nathanpc/mini12/images/Amplifier.png

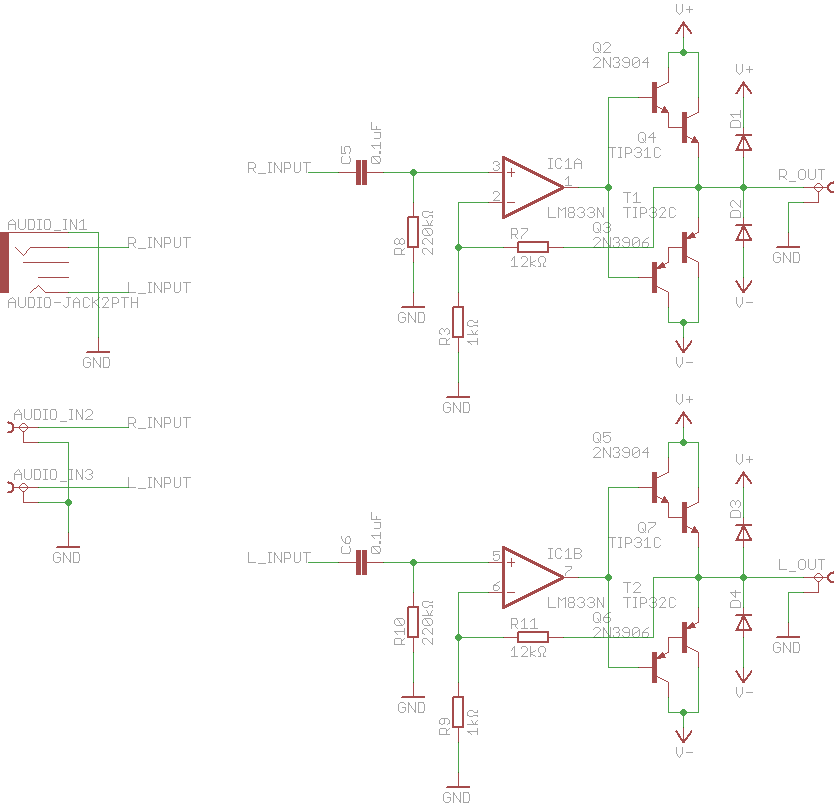
images/Amplifier.png
