nathanpc/mini12/images/Clipping Detector.png

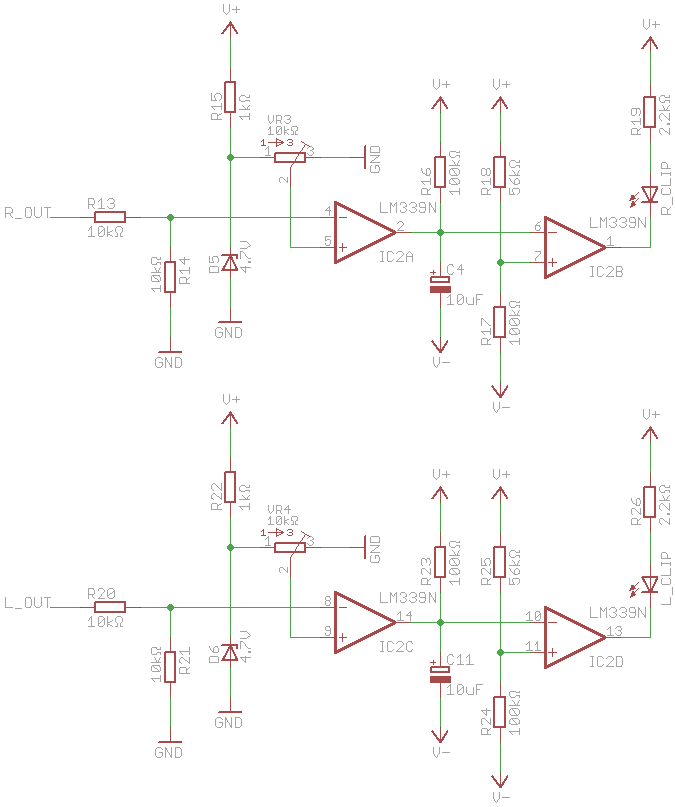
images/Clipping Detector.png
