nathanpc/mini12/images/Power Supply.png

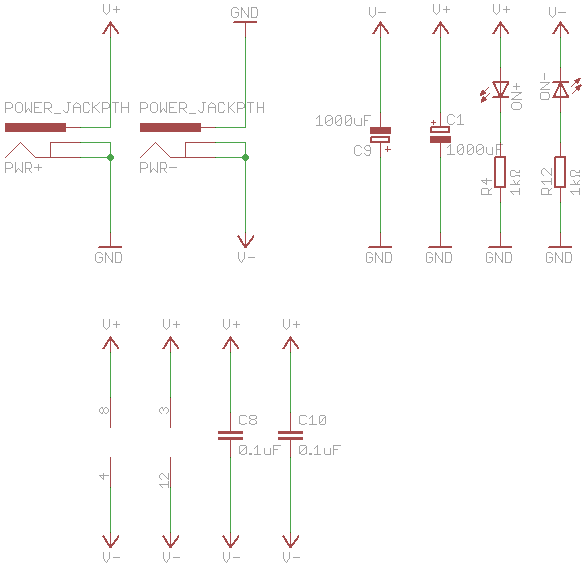
images/Power Supply.png
