nathanpc/mini12/Simulation.asc

C3: polcap; 1000µ
C4: polcap; 1000µ
C7: cap; 10µ
C9: cap; 0.22µ
D1: diode; 1N4148
D2: diode; 1N4148
Q2: npn; ""
Q3: pnp; ""
Q4: npn; 2N3904
Q5: pnp; 2N3906
R5: res; 100k
R6: res; 12k
R7: res; 8
R8: res; 1k
R17: res; 10k
R18: res; 10k
R20: res; 100k
R21: res; 1k
R22: res; 100k
R23: res; 56k
U1: opamp2; LM833
U3: LM339
U4: LM339
V1: voltage; 9V
V2: voltage; -9V
V3: voltage; SINE(0V 500mV 1kHz)
V4: voltage; 3.5V
Named nets: 0, V+, V-, Input, Output, opinput, Overload
.tran 0 10ms 0 1u
.options plotwinsize=0
.lib LM833.sub
.MODEL tip31 npn
+IS=1e-09 BF=3656.16 NF=1.23899 VAF=10
+IKF=0.0333653 ISE=1e-08 NE=2.29374 BR=0.1
+NR=1.5 VAR=100 IKR=0.333653 ISC=1e-08
+NC=1.75728 RB=6.15083 IRB=100 RBM=0.00113049
+RE=0.0001 RC=0.0491489 XTB=50 XTI=1
+EG=1.05 CJE=3.26475e-10 VJE=0.446174 MJE=0.464221
+TF=2.06218e-09 XTF=15.0842 VTF=25.7317 ITF=0.001
+CJC=3.07593e-10 VJC=0.775484 MJC=0.476498 XCJC=0.750493
+FC=0.796407 CJS=0 VJS=0.75 MJS=0.5
+TR=9.57121e-06 PTF=0 KF=0 AF=1
.MODEL tip32 pnp
+IS=1e-09 BF=134.366 NF=1.29961 VAF=10
+IKF=0.742988 ISE=1e-16 NE=1.40014 BR=0.1
+NR=1.46599 VAR=100 IKR=3.21978 ISC=1e-16
+NC=2.71657 RB=7.44433 IRB=2.41268 RBM=0.218936
+RE=0.0152284 RC=0.0761421 XTB=0.1 XTI=1
+EG=1.05 CJE=3.26474e-10 VJE=0.446178 MJE=0.464223
+TF=1e-08 XTF=3.50642 VTF=8.2848 ITF=0.0305862
+CJC=3.07595e-10 VJC=0.77548 MJC=0.476497 XCJC=0.799334
+FC=0.8 CJS=0 VJS=0.75 MJS=0.5
+TR=9.57121e-06 PTF=0 KF=0 AF=1
.four 1kHz 10 v(output)
Power Amplifier
(12x Gain)
