nathanpc/mini12/Mini12.sch

## EAGLE design Mini12.sch (2014-07-29)

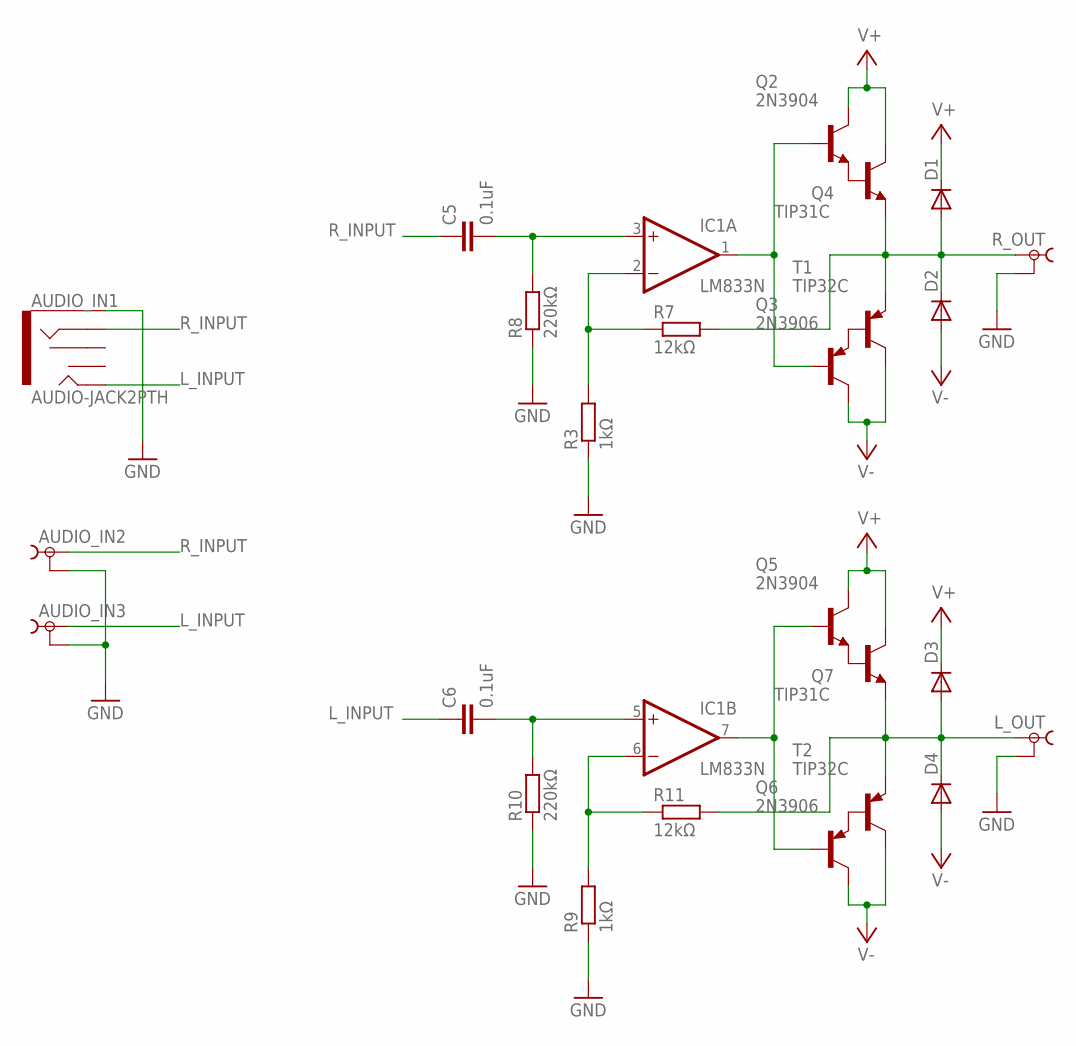
[picture p4: schematic Mini12.sch, sheet 1]

Parts:
AUDIO_IN1: AUDIO-JACK2PTH; AUDIO-JACK
AUDIO_IN2, AUDIO_IN3: TOBU3
C5, C6: 0.1uF; C025-025X050
D1, D2, D3, D4: 1N4148DO35-7; DO35-7
IC1: LM833N; DIL08
L_OUT: TOBU3
Q2, Q5: 2N3904; TO92
Q3, Q6: 2N3906; TO92
Q4, Q7: TIP31C; TO220
R3, R9: 1kΩ; 0207/10
R7, R11: 12kΩ; 0207/10
R8, R10: 220kΩ; 0207/10
R_OUT: TOBU3
T1, T2: TIP32C; TO220

Connections:
GND: AUDIO_IN1.SLEEVE, AUDIO_IN2.2, AUDIO_IN3.2, L_OUT.2, R3.1, R8.1, R9.1, R10.1, R_OUT.2
L_INPUT: AUDIO_IN1.TIP, AUDIO_IN3.1, C6.1
unnamed: IC1.2 (-IN), R3.2, R7.1
unnamed: C5.2, IC1.3 (+IN), R8.2
unnamed: IC1.6 (-IN), R9.2, R11.1
unnamed: C6.2, IC1.5 (+IN), R10.2
unnamed: Q2.3 (E), Q4.1 (B)
unnamed: Q3.3 (E), T1.1 (B)
unnamed: D1.A, D2.C, Q4.3 (E), R7.2, R_OUT.1, T1.3 (E)
unnamed: IC1.1 (OUT), Q2.2 (B), Q3.2 (B)
unnamed: Q5.3 (E), Q7.1 (B)
unnamed: Q6.3 (E), T2.1 (B)
unnamed: D3.A, D4.C, L_OUT.1, Q7.3 (E), R11.2, T2.3 (E)
unnamed: IC1.7 (OUT), Q5.2 (B), Q6.2 (B)
R_INPUT: AUDIO_IN1.RING, AUDIO_IN2.1, C5.1
V+: D1.C, D3.C, Q2.1 (C), Q4.2 (C), Q5.1 (C), Q7.2 (C)
V-: D2.A, D4.A, Q3.1 (C), Q6.1 (C), T1.2 (C), T2.2 (C)

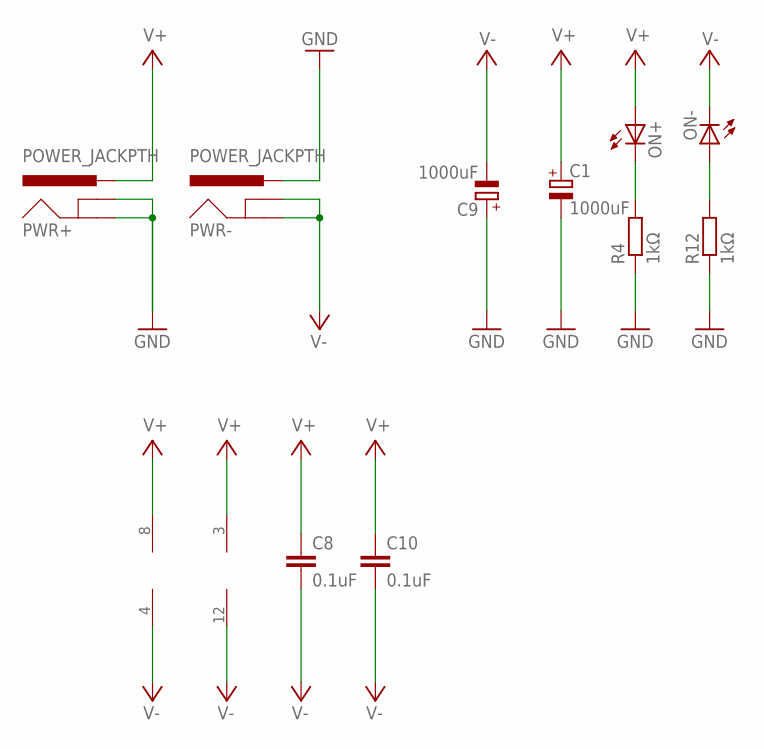
[picture p5: schematic Mini12.sch, sheet 2]

Parts:
C1, C9: 1000uF; E2,5-6
C8, C10: 0.1uF; C025-025X050
IC1: LM833N; DIL08
IC2: LM339N; DIL14
ON+: LEDSQR2X5; LED2X5
ON-: LEDSQR2X5; LED2X5
PWR+: POWER_JACKPTH; POWER_JACK_PTH
PWR-: POWER_JACKPTH; POWER_JACK_PTH
R4, R12: 1kΩ; 0207/10

Connections:
GND: C1.-, C9.+, PWR+.GND, PWR+.GNDBREAK, PWR-.PWR, R4.1, R12.1
unnamed: ON-.A, R12.2
unnamed: ON+.K (C), R4.2
V+: C1.+, C8.1, C10.1, IC1.8 (V+), IC2.3 (V+), ON+.A, PWR+.PWR
V-: C8.2, C9.-, C10.2, IC1.4 (V-), IC2.12 (GND), ON-.K (C), PWR-.GND, PWR-.GNDBREAK

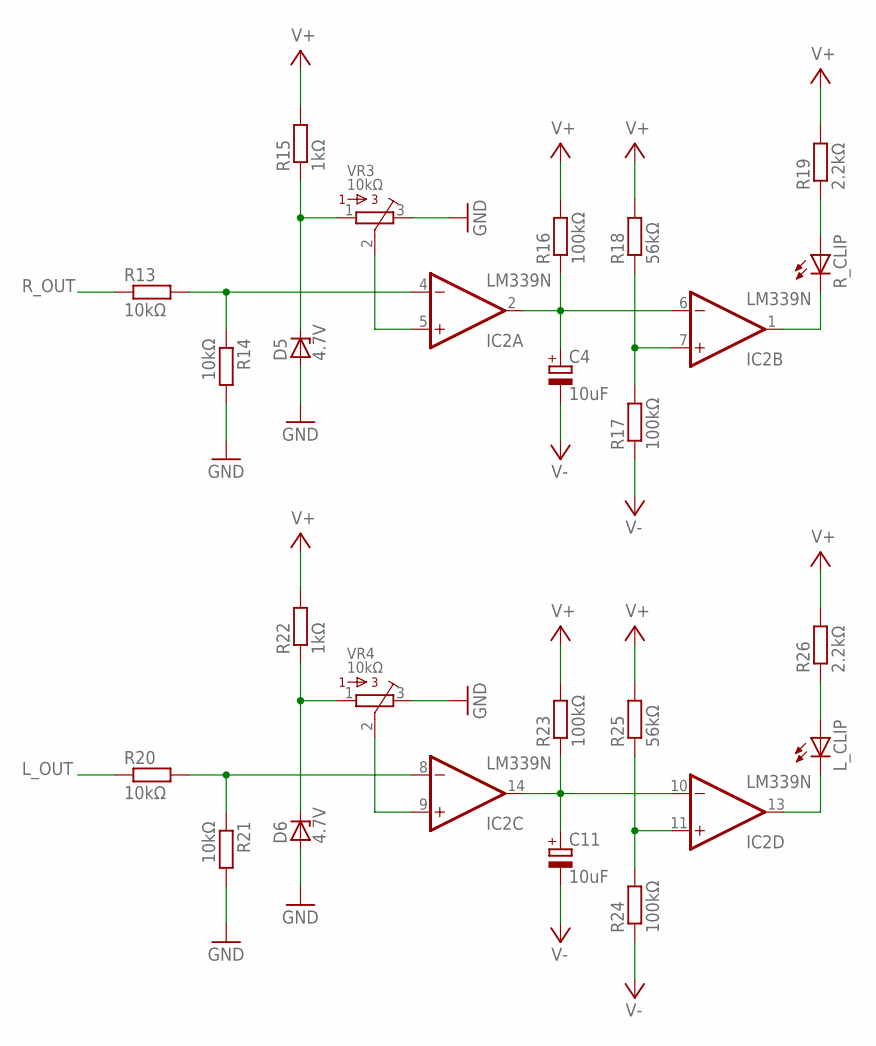
[picture p6: schematic Mini12.sch, sheet 3]

Parts:
C4, C11: 10uF; E2,5-6
D5, D6: 4.7V; DO34Z7
IC2: LM339N; DIL14
L_CLIP: LED5MM
R13, R14, R20, R21: 10kΩ; 0207/10
R15, R22: 1kΩ; 0207/10
R16, R17, R23, R24: 100kΩ; 0207/10
R18, R25: 56kΩ; 0207/10
R19, R26: 2.2kΩ; 0207/10
R_CLIP: LED5MM
VR3, VR4: 10kΩ; 3362U

Connections:
GND: D5.A, D6.A, R14.2, R21.2, VR3.3, VR4.3
L_OUT: R20.1
unnamed: IC2.4 (-IN), R13.2, R14.1
unnamed: IC2.5 (+IN), VR3.2
unnamed: D5.C, R15.1, VR3.1
unnamed: C4.+, IC2.2 (OUT), IC2.6 (-IN), R16.1
unnamed: IC2.7 (+IN), R17.2, R18.1
unnamed: IC2.1 (OUT), R_CLIP.K (C)
unnamed: R19.1, R_CLIP.A
unnamed: IC2.8 (-IN), R20.2, R21.1
unnamed: IC2.9 (+IN), VR4.2
unnamed: D6.C, R22.1, VR4.1
unnamed: C11.+, IC2.10 (-IN), IC2.14 (OUT), R23.1
unnamed: IC2.11 (+IN), R24.2, R25.1
unnamed: IC2.13 (OUT), L_CLIP.K (C)
unnamed: L_CLIP.A, R26.1
R_OUT: R13.1
V+: R15.2, R16.2, R18.2, R19.2, R22.2, R23.2, R25.2, R26.2
V-: C4.-, C11.-, R17.1, R24.1
