nathanpc/mini12/(commit log)

2014-07-29 Unfinished schematic
    [Mini12.sch]
2014-07-29 Added some schematics to the README
2014-07-29 Finished schematic
    [Mini12.sch]
2014-07-29 Added the schematic to the README
2014-08-03 Added the BOM
    [BOM.csv]
2014-08-03 Added a photo of it assembled
